CORIOTLAB/LoRaScope/docs/images/gnss_visibility_map.png

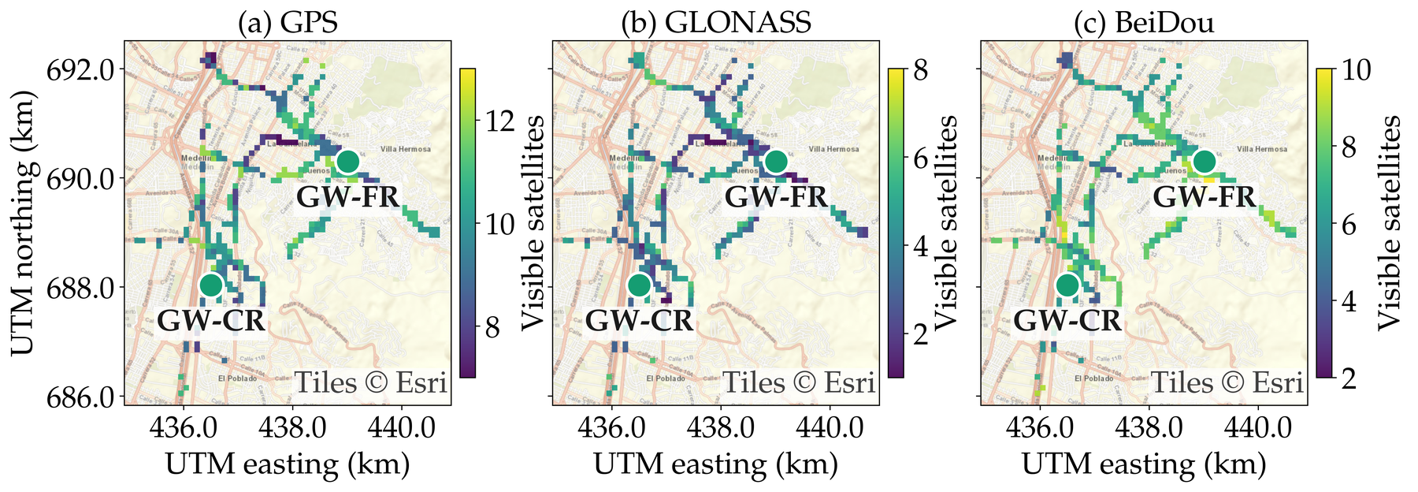
docs/images/gnss_visibility_map.png
