CORIOTLAB/LoRaScope/hardware/cad/step/k063_base.step

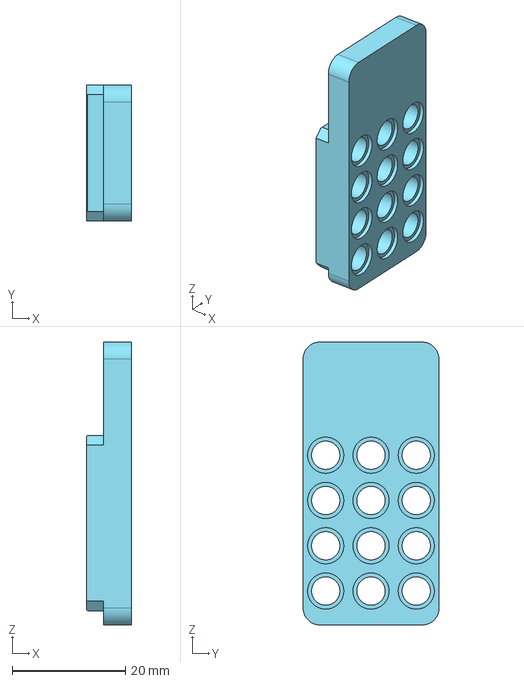
[picture p5: CAD file, 2026-11-09]
hardware/cad/step/k063_base.step
8.00 x 24.0 x 50.0 mm
