CORIOTLAB/LoRaScope/hardware/cad/step/Battery_base.step

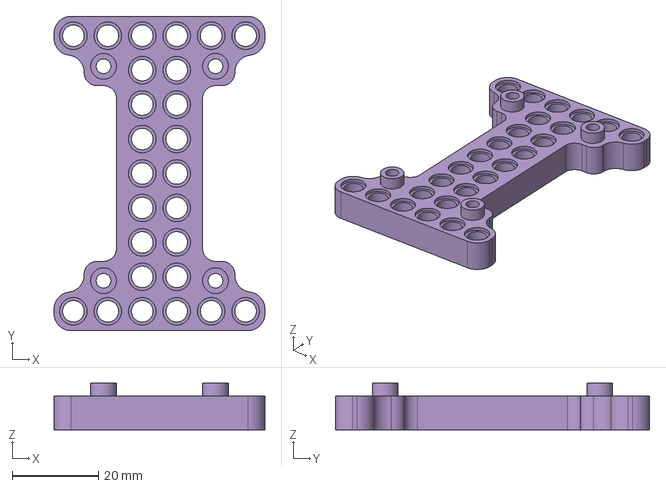
[picture p6: CAD file, 2026-11-09]
hardware/cad/step/Battery_base.step
49.0 x 73.0 x 10.8 mm
