CORIOTLAB/LoRaScope/(list of files, cad)

Other CAD files:
hardware/cad/stl/Battery_base.stl
hardware/cad/stl/k063_base.stl
