CORIOTLAB/LoRaScope/CHANGELOG.md

# Changelog

All notable changes to this repository are documented here. The format follows
[Keep a Changelog](https://keepachangelog.com/en/1.1.0/).

## [Unreleased]

### Added
- Firmware sketch, `CORIOT_*` libraries and ChirpStack payload decoder (payload version 2).
- STEP and STL files of the two 3D-printed adapters (`Battery_base`, `K063_base`).
- Six campaign datasets with a data dictionary.
- Decoder round-trip test, run by GitHub Actions.
