CORIOTLAB/LoRaScope/(notices)

Notices in the files:
README.md:
Hardware: CERN-OHL-P-2.0
Data: CC BY 4.0
